KimJorgensen/KungFuFlash2/pics/launcher.jpg

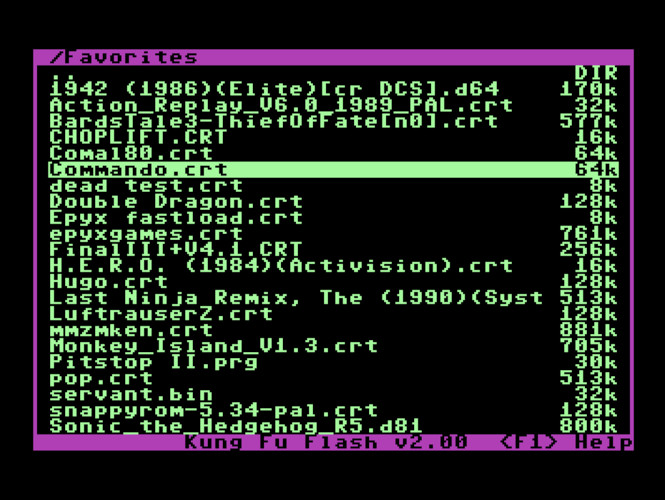
pics/launcher.jpg
