KimJorgensen/KungFuFlash2/pics/cartridge_case.jpg

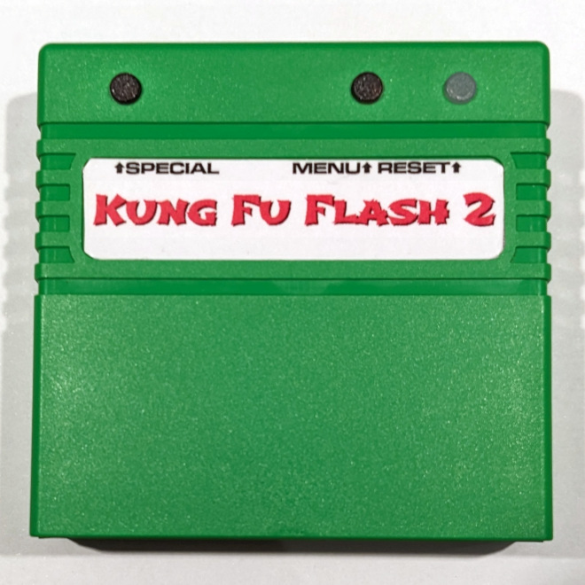
pics/cartridge_case.jpg
