KimJorgensen/KungFuFlash2/README.md

# Kung Fu Flash 2

Project is moved to https://codeberg.org/KimJorgensen/KungFuFlash2
