KimJorgensen/KungFuFlash2/pics/label_600dpi.png

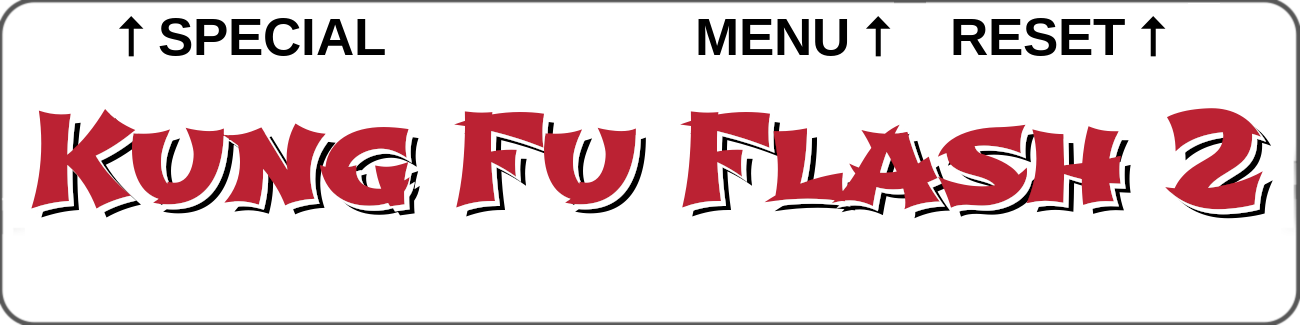
pics/label_600dpi.png
