KimJorgensen/KungFuFlash2/pics/pcb_prototype.jpg

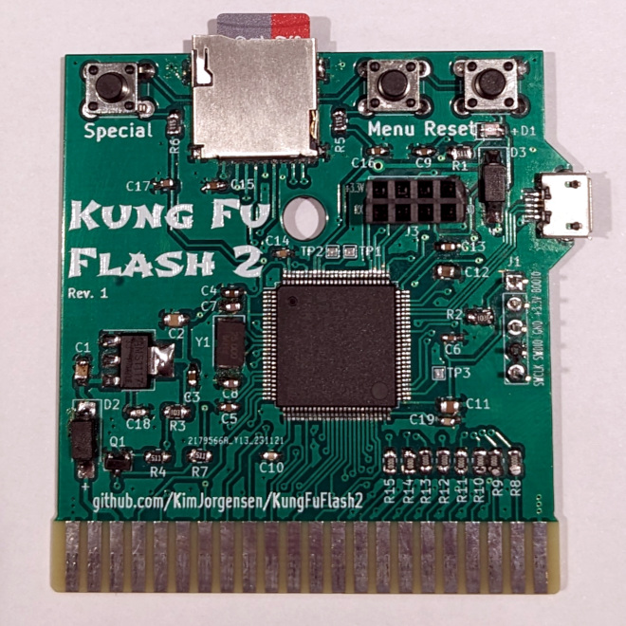
pics/pcb_prototype.jpg
