KimJorgensen/KungFuFlash2/(threads)

Thread 3 (2024-12-22):

Commodore 64C problem

LouDnl, 2024-12-22:
This issue is indirectly related to
https://github.com/KimJorgensen/KungFuFlash/issues/89

Sorry in advance for bumping an old issue for another cartridge in this repo.
I seem to have a very similar issue with my Rev A but then with Kungfu Flash 2.
Kf2 works fine in other mainboards, but in the rev A only a black screen appears.
Any tips or pointers on where too start with getting it to work?
I know the cartridge works, the diagnostics menu starts a serial log over USB and I can change the timing (max 30 up and down).

**Serial log:**
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

**Mainboard:**
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

**Clock:**
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

**Video output check of black screen:**
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

**Magicdesk reference signal:**
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

KimJorgensen, 2024-12-26:
It could be that your C64C requires a small positive [phi2 clock offset](https://github.com/KimJorgensen/KungFuFlash2/blob/main/firmware/README.md#diagnostic) or that there is a hardware connection issue. You could try to clean the connector on the PCB.

LouDnl, 2024-12-26:
> It could be that your C64C requires a small positive [phi2 clock offset](https://github.com/KimJorgensen/KungFuFlash2/blob/main/firmware/README.md#diagnostic) or that there is a hardware connection issue. You could try to clean the connector on the PCB.

I have tried this from -30 up to +30 without success unfortunately. Since 30 is the max offset I have tried adjusting the max offset in your firmware which allows me more then 30, but u fortunately the offset is still maxed at 30 somewhere else.
It's not the cartridge, as another kff2 cartridge that is tested to work in a c64 has the same issue in mine.
So that leaves the motherboard cartridgeslot or the need for a larger then 30 offset I guess?

KimJorgensen, 2024-12-26:
It is unlikely that you need a offset larger than 30. Normally an offset of one or two should fix the issue.
Maybe the expansion slot is dirty or broken. Have you tried with another cartridge like Easy Flash or Final Cartridge III?

LouDnl, 2024-12-26:
> It is unlikely that you need a offset larger than 30. Normally an offset of one or two should fix the issue.
> Maybe the expansion slot is dirty or broken. Have you tried with another cartridge like Easy Flash or Final Cartridge III?

Atm I only have 2 MagicDesk cartridges besides kff2 and they work fine.

LouDnl, 2024-12-28:
Issue found and fixed, wasn't kff2 related in the end. It turned out to be a trace on the underside of the pcb that got damaged when replacing the old RF module with a replacement one.
This trace was for Read/Write, kind of important I recon 🤣
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

KimJorgensen, 2024-12-28:
Great! I'll close this issue

Closed 2024-12-28.

Thread 4 (2024-12-26):

Bom error

ZaPpi3, 2024-12-26:
Y1 is a 4pin part in the BOM and the footprint is for 2pin part.
Something like this should work:
https://www.aliexpress.com/item/1005008177194359.html

KimJorgensen, 2024-12-28:
Thank you for reporting. The BOM has now been updated with a new link.

Closed 2024-12-28.

Thread 6 (2025-01-06):

Kung Fu Flash 2 - timing issue on MEGA65 (looks similar to KFF issue #195)

adtbm, 2025-01-06:
**Describe the bug**
Using the KFF2 in MEGA65, not possible to enter Menu again after selecting a CRT or D64.
**Probable timing issues**. The screen flickers, changes whenever i press the menu button again, but menu will not loaad

Only when i delete the KFF2.cfg on the SDcard then the menu shows up again (until ii select next file)

**To Reproduce**
Steps to reproduce the behavior:
1. power MEGA65 on
2. select a CRT or D64
3. once started, press menu button

**Expected behavior**
It should go back to KFF2 menu.

If applicable, add screenshots to help explain your problem.
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

**Kung Fu Flash 2 (please complete the following information):**
 - Hardware: Rev. 1
 - Firmware: 2.02
**Computer (please complete the following information):**
 - Device: MEGA65
 - Kernal: stock & JiffyDOS

**Additional context**
Add any other context about the problem here.

KimJorgensen, 2025-01-11:
The Kung Fu Flash 2 is only intended to be used with original Commodore hardware as stated in the README:
`Kung Fu Flash 2 will work with the PAL and NTSC version of the Commodore 64 or Commodore 128.`

I'll label this as "won't fix", unless someone is willing to analyze exactly why there is an incompatibility with the MEGA65 and can come up with a compelling reason why this requires changes to the Kung Fu Flash 2 and not the MEGA65.

Sorry, but I don't have the hardware or time to support modern recreations of the Commodore 64

Closed 2025-01-17.

Thread 7 (2025-01-07):

Programming the stm

steswart, 2025-01-07:
I have built and programmed a couple of your original kung fu flash carts without any issue. However i am unable to program tis STM chip with the same st-link v2 programmer.
Could it be fake ic’s? I used the aliexpress link from your BOM.

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

i am getting an unable to connect issue. All pins are soldered properly with no shorts.

i am missing the Schotty diodes, but surely i do not need them to program the STM32?

steswart, 2025-01-10:
I managed to program it with dfu-util command line.

steswart, 2025-01-14:
Lol, as you can see from the screenshot on top I used the wrong programming software.
It also programs fine with stmcubeprogrammer.

Closed 2025-01-10.

Thread 9 (2025-01-14):

Kernal emu

dikdom, 2025-01-14:
Hello Kim,

I just would like ask if you're planning to implement the kernal switch feature which wasn't possible with the original KFF. I was wondering if this more powerful MCU would be capable of handling the proper lines with proper timing...

Thanks!

kiFlaFlaki, 2025-01-15:
Also same question. That indeed will be fantastic feature!

dlasher, 2025-03-18:
+1 fantastic idea for a great product

Thread 13 (2025-02-03):

fimware installation problem KFF2

Kingagames77, 2025-02-03:
Hello. I've got problem to connect cart to ST-Link V2 programmer
 ST-LINK SN : 6068FF286068FF286068FF28
20:01:57 : V2J39S7
20:01:57 : Connected via SWD.
20:01:57 : SWD Frequency = 4,0 MHz.
20:01:57 : Connection mode : HotPlug.
20:01:57 : Debug in Low Power mode enabled.
20:01:57 : Can not connect to the target!
20:02:05 : Unexpected error

Unexpected error? Am I doing something wrong. With KFF1 there's no problem to connect.
Please help

Kingagames77, 2025-02-03:
Sorry I didn't use right program stm32cubeprogrammer but after installed and connected, started programming and...

20:40:32 : Opening and parsing file: KungFuFlash_v2.02.bin
  20:40:32 : Memory Programming ...
  20:40:32 :   File          : KungFuFlash_v2.02.bin
  20:40:32 :   Size          : 128.00 KB
  20:40:32 :   Address       : 0x08000000
  20:40:32 : Download in Progress:
  20:40:33 : File download complete
  20:40:33 : Time elapsed during download operation: 00:00:00.990
  20:40:33 : Verifying ...
  20:40:33 : Read progress:
  20:40:34 : Error: Data mismatch found at address  0x08000000 (byte = 0x38 instead of 0x00)
  20:40:34 : Error: Download verification failed
  20:40:34 : Memory [0x08000000 : 0x08020000] - Checksum : 0x01A4E236

steswart, 2025-02-03:
I had a problem too, but it worked every time for me when I used the USB method below.

USB
Add a jumper to short BOOT0 and +3.3V on J1. This will ensure that the board is started in DFU mode.

Use [dfu-util](http://dfu-util.sourceforge.net/) to install the firmware:

dfu-util -a 0 -s 0x08000000 -D KungFuFlash_v2.xx.upd

The jumper should be removed after the firmware has been installed.

Kingagames77, 2025-02-05:
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
What am I doing wrong??

Closed 2025-03-13.

Thread 14 (2025-02-09):

KFF2 Feature proposal at forum64.de

jueank, 2025-02-09:
Hi Kim,
I wrote you a private message in forum64.de. It's a feature proposal for KFF2, but not a straight forward one. It would be very nice if you will have a look. And sorry for raising an issue here. I could not find any other contact data.

Closed 2025-04-07.

Thread 15 (2025-02-21):

Menu button freezes C64

haktho, 2025-02-21:
I'm reaching out hoping to get some help with an issue I have using the Kung Fu Flash. The Menu button does not work. The screen is filled with garbage and the C64 freezes. The computer is a breadbin with a 250425 motherboard. I have run the Diagnostic Cartridge Rev. 586220 with harness, and everything seems ok, and that is the only other cartridge I have.

- I have tried to change the phi2 offset, both increasing and decreasing it, but with no effect.
- I have done thorough cleaning of both cartridge and port and also put support under the pcb to prevent flexing when pressing the buttons. To rule out bad contact.
- I have done visual inspection of the C64 motherboard solder joints and done _some_ continuity testing

Cartridge images seem to work fine though (the KFF works on another 250425 C64, that is how I can select a crt file to use, and also adjust the phi2 offset). Could there be some problem with the reset circuit involving the cartridge port specifically, as the Reset button on the KFF does not work either? Any help is much appreciated. (I have read the existing old issue threads, without finding a solution)

Thanks!

KimJorgensen, 2025-02-21:
The reset button should work and this does indeed suggest a problem with reset circuit.

I would recommend measuring the reset signal on expansion port and see what happens when you press the reset button

haktho, 2025-02-22:
Thank you so much for responding, here are some updates.

Reset circuit continuity verified all over the board.
•	Expansion port pin3
•	U18 SID pin5
•	U8 7406 pin8
•	U1 and U2 CIAs pin34
•	U7 CPU pin40
•	User port pin3
•	C154
•	R36

When using the reset button on the KFF the green led on the cartridge lights up and stays on.
My diagnostic cartridge also has a reset button, so I tested that, and it works fine.

I have also measured the reset signal. When using reset button on KFF the reset signal does not go low, it stays high. When using the reset on diagnostic cartridge the reset signal goes low, and then high again when the C64 is reset.

Some additional information that might be helpful in troubleshooting.
•	The CPU is mos 8500R3, not the regular 6510
•	The U20 556 is somewhat odd amongst the other chips on the board. It is a TI NE556N.

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

KimJorgensen, 2025-02-23:
I would have expected a voltage drop on the reset line when pressing the reset button. Is there continuity from the reset line on C64 to Q1 on the Kung Fu Flash 2?

It could also be a problem with R3 or R4 on the Kung Fu Flash 2. You could measure the resistance of these. There is also the possibility that Q1 is bad and needs to be replaced

haktho, 2025-02-23:
Continuity from reset line on the motherboard to Q1 verified.
Resistance measured on R3 and R4 are 9.9k and 509 Ohms.

I now see that I opened the issue for the wrong repo, I have a Kung Fu Flash (https://github.com/KimJorgensen/KungFuFlash), not version 2. Sorry about that. Should I close this one, and open another in the correct repo?

KimJorgensen, 2025-02-23:
You can just leave the issue here. The reset circuit is the same on both Kung Fu Flash 1 and 2.

Which transistor did you use for Q1?

haktho, 2025-02-25:
BC817-40, JLC-PCB part number C8589.

Also I am experiencing more and more issues with the KFF, even on the other C64 where the cartridge previously worked fine. Like random reset, game errors, crts wont work, read/write errors from both disk and tape. When I remove the KFF everything works fine.

KimJorgensen, 2025-03-15:
Sounds like a hardware problem with your Kung Fu Flash cartridge. Sorry, I can't help with that

Closed 2025-03-15.

Thread 16 (2025-02-23):

Reset will not work on MEGA64 (yet)

Kugelblitz360, 2025-02-23:
More a type of warning then an actual issue that Kim can fix:

Once a .crt is mounted, any kind of Reset, including Power Cycling, will fail on a MEGA65. My guess is that while the KFF2 initializes, it pulls the DMA line to halt the CPU (like Sidekick64). This will fail with a MEGA65 as it does not honour the DMA line (yet) in the C64 core.

Pressing the MENU button will work, so you will not be in an unusable state, but don't be alarmed when your screen stays black after you turn on your MEGA65 - you just need to press MENU.

KimJorgensen, 2025-02-23:
For info, Kung Fu Flash 2 does not use the DMA line during reset or for the menu. The DMA line is only used by the REU emulation

Kugelblitz360, 2025-02-23:
Thanks, then we need to debug the reset behaviour on our end.

Thread 21 (2025-03-18):

FEATURE REQUEST: CLEAR LAST SAVED

dlasher, 2025-03-18:
**Is your feature request related to a problem? Please describe.**
Yes. Often when booting or rebooting, I'd like the KFF2 to come up with ZERO loaded CRT/D64/etc. If you have a D64 selected for example, hitting reset will not go into the cart, but auto-mount the D64, and auto load the first program.

**Describe the solution you'd like**
Three notes:
1. top or bottom banner should show currently saved choice "CASWOLF.D64" or "supersnap5.crt"
2. In the menus - have a key/F5 for "clear last saved" or "selected = none"
3. In the settings - have an option for "auto clear last choice on cold boot"

Thank you!

erebos007, 2025-05-05:
F8 is killing everything, Menu included alas. Then after reboot the Menu does not show up automatically.
Would it be possible to make it a kill and restore menu  or make it delete the .kff2.cfg settings file ?

Thread 28 (2025-06-25):

PCBWay: question with assembly

ragraphics, 2025-06-25:
Hi,
I am interested in your Kungfu flash v 2 on PCBway,
but they say to me:
"
There are some questions in the BOM and we have not received a response after contacting the author several times, so we cannot provide a full quote, this order cannot be processed.
Or could you pls check and reply the questions in the attached file?
"

Can you help me?

ragraphics, 2025-06-25:
[Kung Fu Flash v2.00 by Kim J_rgensen_BOM_PCBWay_20241125.xlsx](https://github.com/user-attachments/files/20902400/Kung.Fu.Flash.v2.00.by.Kim.J_rgensen_BOM_PCBWay_20241125.xlsx)

ragraphics, 2025-06-25:
is this kungfu flash a REU expansion memory for C64?

KimJorgensen, 2025-06-25:
Sorry, but I'm not the author of the project on PCBWay. Please restrict issues to the content of this repository.

The REU feature is described in the readme

Closed 2025-06-25.

Thread 29 (2025-07-20):

Incorrect 30719 BASIC BYTES shown when KFF2 used with JaffyDOS

oschonrock, 2025-07-20:
- KFF2 with firmware 2.0.3
- C64C shortboard
- JaffyDOS v1.3 - stock ROM and JiffyDOS are fine

To reproduce:
1. install JaffDOS
2. plug in KFF2
3. from KFF2 menu select "F8 Kill"  ( "F7 - Basic" always exhibits problem as well)

c64 boot screen will show "JaffyDOS - 30719 bytes free"...
Press KFF2 reset button multiple times.
The full and correct 38911 bytes free will be shown ~30% of the time. The other 70% it is 30719bytes.

This "feels" like a race condition.

Some investigation suggests this 300ms delay might could be related:

```c
        case DAT_KILL:
        {
            c64_disable();
            C64_CRT_CONTROL(STATUS_LED_OFF|CRT_PORT_8K); // <-- CRT ROM seems to be active here
            c64_reset(false); // release RESET
            delay_ms(300);
            C64_CRT_CONTROL(CRT_PORT_NONE); // <-- CRT ROM removed
            result = true;
        }
        break;
```

KimJorgensen, 2025-07-20:
The reason is to make the reset unstoppable - see https://www.c64-wiki.com/wiki/Reset_Button

oschonrock, 2025-07-20:
> The reason is to make the reset unstoppable - see https://www.c64-wiki.com/wiki/Reset_Button

That's nice... and does that mean it's normal /intended to lose 8kB RAM if the Kernal is faster than expected? (If indeed that is the reason this is happening.)

KimJorgensen, 2025-07-20:
No it was not intended to lose 8kB RAM. I wonder if it is possible to select a delay that would work with all kernals

oschonrock, 2025-07-20:
> No it was not intended to lose 8kB RAM. I wonder if it is possible to select a delay that would work with all kernals

Maybe difficult... but, if you think it is as simple as adjusting that delay - you have the overview - it might it be possible to make the delay a configuration option, so people can customise it to work with JaffyDOS or whatever?

Plus publish some numbers that work with common options.

KimJorgensen, 2025-07-20:
You can use F6 as a workaround. The reset will however not be unstoppable

RetroNynjah, 2025-07-20:
I don't have a working build environment but if someone can build a few test versions with different delays, we can test what works with JaffyDOS and what doesn't.
It won't tell us what works best for everyone but at least we will know what would be needed for JaffyDOS to work correctly.

RetroNynjah, 2025-07-21:
There are several other Kernals that skip the RAM test and just check the block starting at $8000.
SpeedDOS and DolphinDOS are two examples and they both show the same behaviour as JaffyDOS. I haven't measured if the repeatability is the same since it feels a bit random but I doubt there's a difference.

Thread 32 (2025-08-05):

Can not connect to the target

ragraphics, 2025-08-05:
ST-Link v2 message error "Can not connect to the target".

I am using windows 10 Pro and a new installation of STM32 ST-LINK Utility v.4.6

In the picture you can see the connection between KFF2 and ST-Link v2 :
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

This is the configuration of ST-Link v2:
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

When I try to connect, here is the message error:
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

This is my board of KFF2 and I am trying to flash the first firmware:
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

Please help me!!!

Thread 33 (2025-08-07):

What is the J3 connector for, how can I use it?

ragraphics, 2025-08-07:
What is the J3 connector for, how can I use it?

KimJorgensen, 2025-08-09:
It is intended for wifi support but there is no support for that in the current firmware.
I'll close this as a duplicate

Closed 2025-08-09.

Thread 36 (2025-10-04):

Unstable behaviour

peppotto-sketch, 2025-10-04:
Hello,

I'm facing stabiity problem, sometimes the cartridge works as aspected sometimes it keeps resetting. I've cleaned all KF2 motherboard using isopropyl alcohol, and so i did with my old breadbin c64 cartridges connector, but nothing to do. Any time it seems to be working and stable at next run the cartridge keep back resetting. I've tried out the KF1 as well and it run great without any issue.

Any help/suggestion is really appreciated.
