KimJorgensen/KungFuFlash2/hardware/KungFuFlash2.pdf

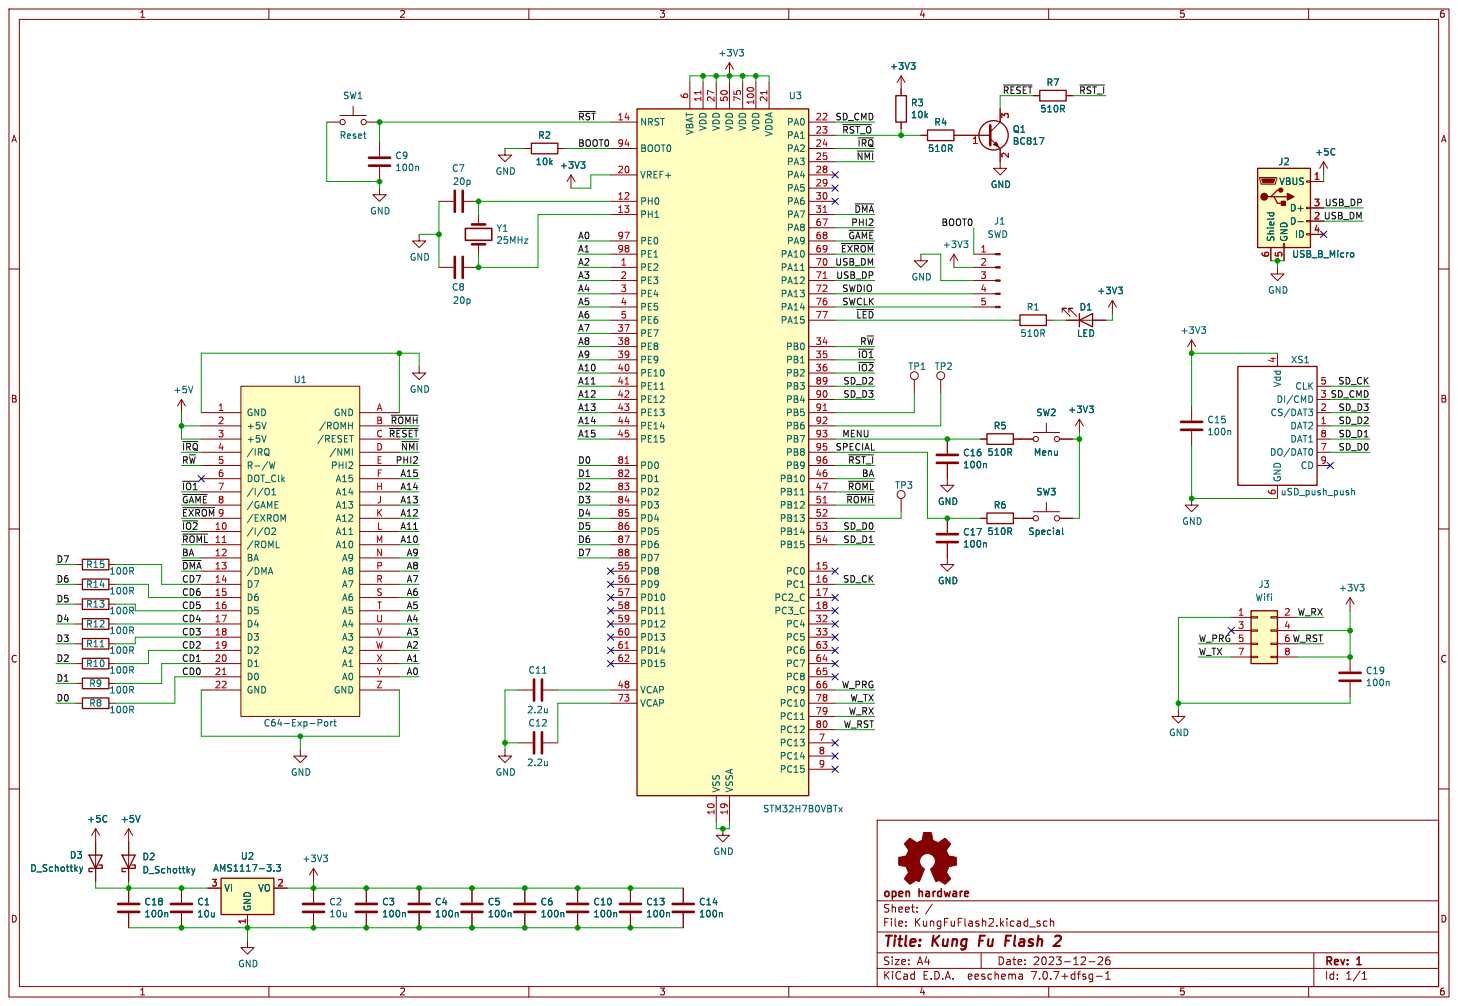
[picture p5: page 1]

Id: 1/1 Title: Kung Fu Flash 2
