KimJorgensen/KungFuFlash2/hardware/KungFuFlash2.kicad_pcb

## KiCad design hardware/KungFuFlash2.kicad_pcb (2024-06-06)

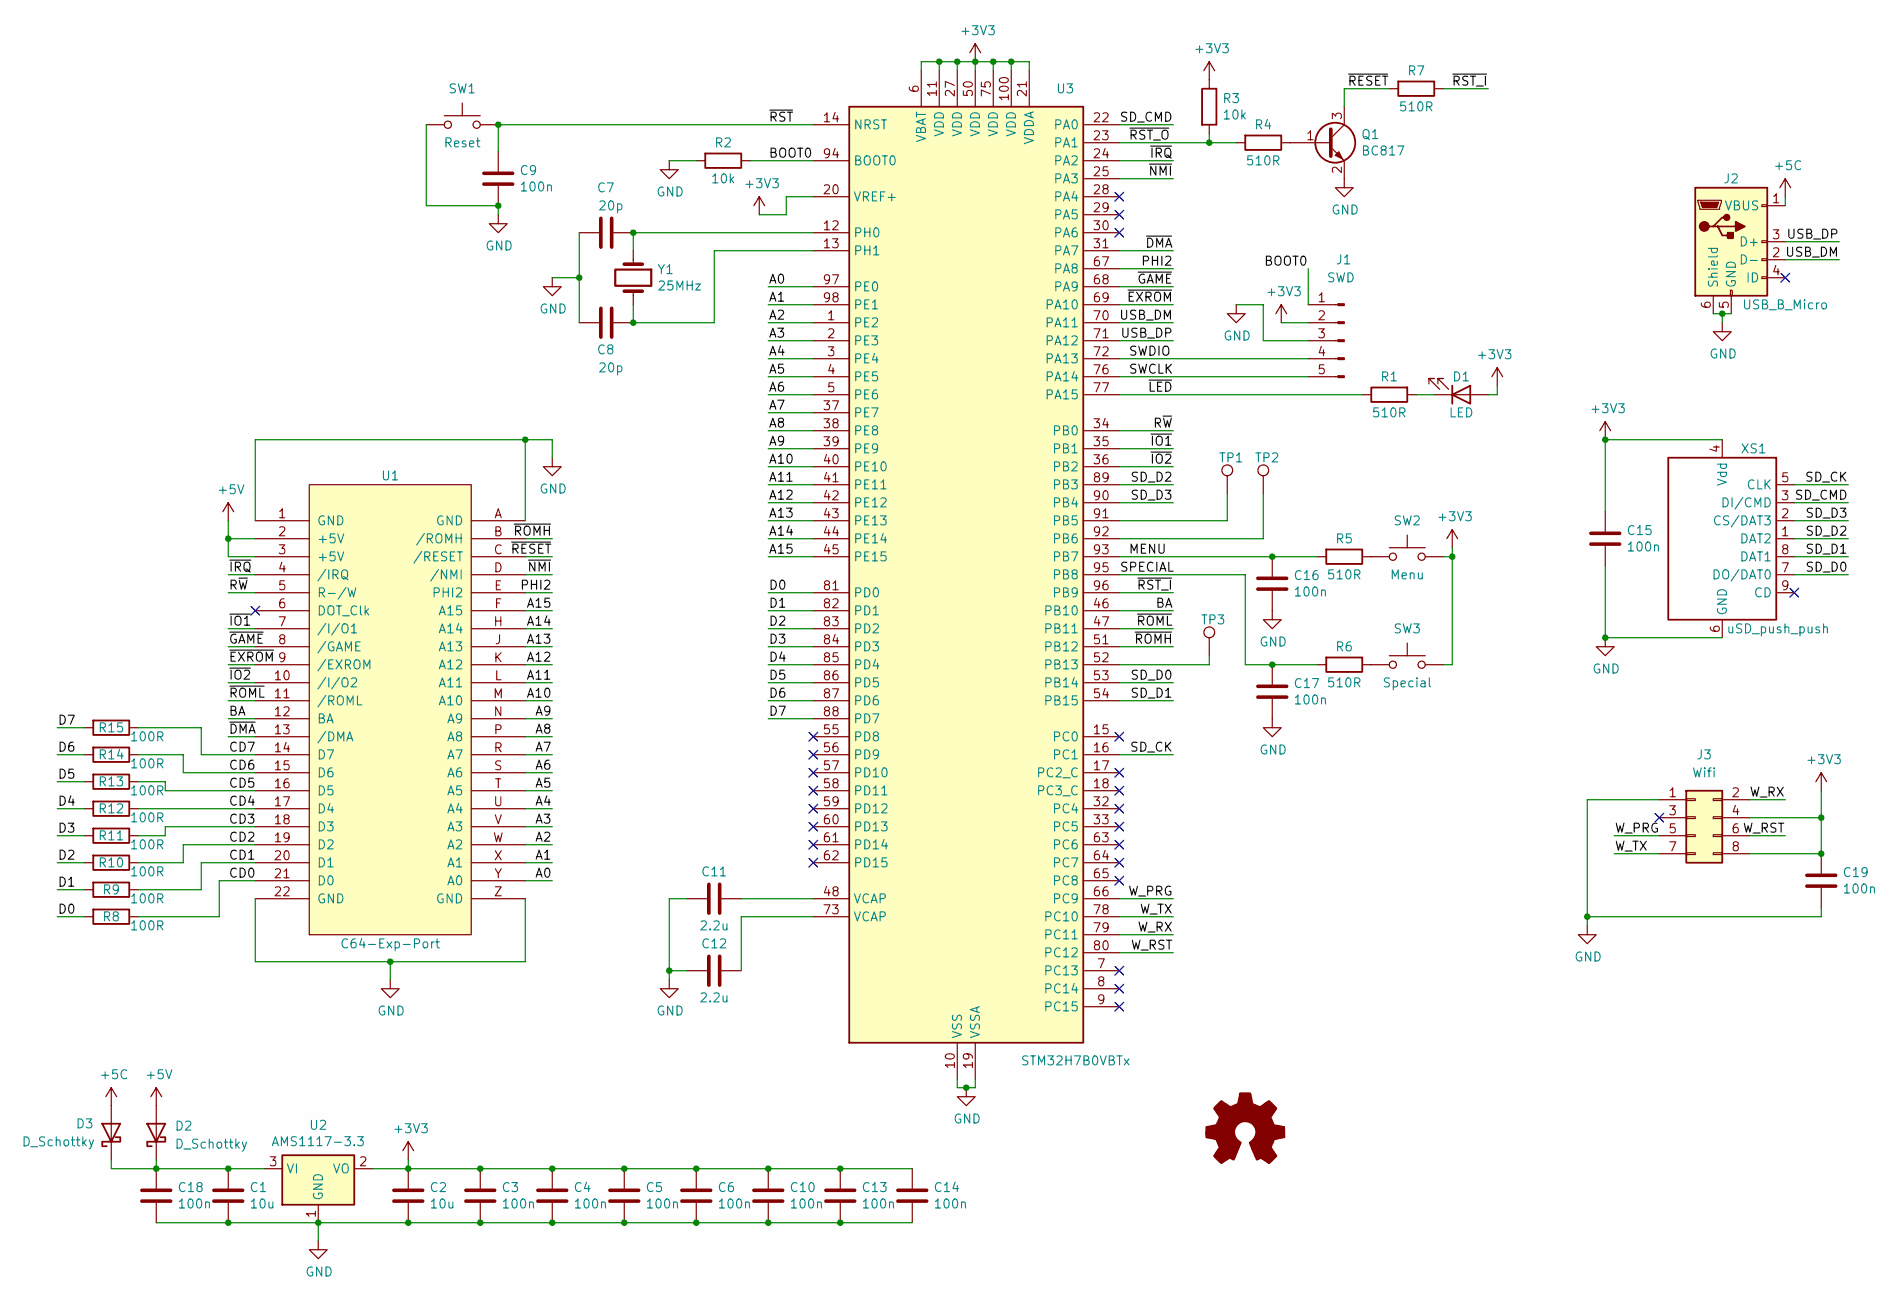
[picture p6: schematic KungFuFlash2.kicad_sch, Kung Fu Flash 2]

Parts:
C1, C2: 10u; C_0805_2012Metric_Pad1.18x1.45mm_HandSolder
C3, C4, C5, C6, C9, C10, C13, C14, C15, C16, C17, C18, C19: 100n; C_0603_1608Metric_Pad1.08x0.95mm_HandSolder
C7, C8: 20p; C_0603_1608Metric_Pad1.08x0.95mm_HandSolder
C11, C12: 2.2u; C_0805_2012Metric_Pad1.18x1.45mm_HandSolder
D1: LED; LED_0805_2012Metric_Pad1.15x1.40mm_HandSolder
D2, D3: D_Schottky; D_SMA_Handsoldering
J1: SWD; PinHeader_1x05_P2.54mm_Vertical
J2: USB_B_Micro; Conn_USBmicro-B_ebay-side_TH
J3: Wifi; PinSocket_2x04_P2.54mm_Vertical
Q1: BC817; SOT-23
R1, R4, R5, R6, R7: 510R; R_0805_2012Metric_Pad1.20x1.40mm_HandSolder
R2, R3: 10k; R_0805_2012Metric_Pad1.20x1.40mm_HandSolder
R8, R9, R10, R11, R12, R13, R14, R15: 100R; R_0805_2012Metric_Pad1.20x1.40mm_HandSolder
SW1: Reset; SW_PUSH_6mm_H8mm
SW2: Menu; SW_PUSH_6mm_H8mm
SW3: Special; SW_PUSH_6mm_H8mm
TP1, TP2, TP3: TestPoint_Pad_1.0x1.0mm
U1: C64-Exp-Port; C64-Cart
U2: AMS1117-3.3; SOT-223-3_TabPin2
U3: STM32H7B0VBTx; LQFP-100_14x14mm_P0.5mm
XS1: uSD_push_push; Conn_uSDcard
Y1: 25MHz; Crystal_SMD_5032-2Pin_5.0x3.2mm

Connections:
+3V3: C2.1, C3.1, C4.1, C5.1, C6.1, C10.1, C13.1, C14.1, C15.1, C19.1, D1.2 (A), J1.2, J3.4, J3.8, R3.1, SW2.1, SW3.1, U2.2 (VO), U3.6 (VBAT), U3.11 (VDD), U3.20 (VREF+), U3.21 (VDDA), U3.27 (VDD), U3.50 (VDD), U3.75 (VDD), U3.100 (VDD), XS1.4 (Vdd)
+5C: D3.2 (A), J2.1 (VBUS)
+5V: D2.2 (A), U1.2 (+5V), U1.3 (+5V)
/A0: U1.Y (A0), U3.97 (PE0)
/A1: U1.X (A1), U3.98 (PE1)
/A2: U1.W (A2), U3.1 (PE2)
/A3: U1.V (A3), U3.2 (PE3)
/A4: U1.U (A4), U3.3 (PE4)
/A5: U1.T (A5), U3.4 (PE5)
/A6: U1.S (A6), U3.5 (PE6)
/A7: U1.R (A7), U3.37 (PE7)
/A8: U1.P (A8), U3.38 (PE8)
/A9: U1.N (A9), U3.39 (PE9)
/A10: U1.M (A10), U3.40 (PE10)
/A11: U1.L (A11), U3.41 (PE11)
/A12: U1.K (A12), U3.42 (PE12)
/A13: U1.J (A13), U3.43 (PE13)
/A14: U1.H (A14), U3.44 (PE14)
/A15: U1.F (A15), U3.45 (PE15)
/BA: U1.12 (BA), U3.46 (PB10)
/BOOT0: J1.1, R2.1, U3.94 (BOOT0)
/CD0: R8.1, U1.21 (D0)
/CD1: R9.1, U1.20 (D1)
/CD2: R10.1, U1.19 (D2)
/CD3: R11.1, U1.18 (D3)
/CD4: R12.1, U1.17 (D4)
/CD5: R13.1, U1.16 (D5)
/CD6: R14.1, U1.15 (D6)
/CD7: R15.1, U1.14 (D7)
/D0: R8.2, U3.81 (PD0)
/D1: R9.2, U3.82 (PD1)
/D2: R10.2, U3.83 (PD2)
/D3: R11.2, U3.84 (PD3)
/D4: R12.2, U3.85 (PD4)
/D5: R13.2, U3.86 (PD5)
/D6: R14.2, U3.87 (PD6)
/D7: R15.2, U3.88 (PD7)
/MENU: C16.1, R5.2, U3.93 (PB7)
/PHI2: U1.E (PHI2), U3.67 (PA8)
/R~W: U1.5 (R-/W), U3.34 (PB0)
/SD_CK: U3.16 (PC1), XS1.5 (CLK)
/SD_CMD: U3.22 (PA0), XS1.3 (DI/CMD)
/SD_D0: U3.53 (PB14), XS1.7 (DO/DAT0)
/SD_D1: U3.54 (PB15), XS1.8 (DAT1)
/SD_D2: U3.89 (PB3), XS1.1 (DAT2)
/SD_D3: U3.90 (PB4), XS1.2 (CS/DAT3)
/SPECIAL: C17.1, R6.2, U3.95 (PB8)
/SWCLK: J1.5, U3.76 (PA14)
/SWDIO: J1.4, U3.72 (PA13)
/USB_DM: J2.2 (D-), U3.70 (PA11)
/USB_DP: J2.3 (D+), U3.71 (PA12)
/W_PRG: J3.5, U3.66 (PC9)
/W_RST: J3.6, U3.80 (PC12)
/W_RX: J3.2, U3.79 (PC11)
/W_TX: J3.7, U3.78 (PC10)
/~DMA: U1.13 (/DMA), U3.31 (PA7)
/~EXROM: U1.9 (/EXROM), U3.69 (PA10)
/~GAME: U1.8 (/GAME), U3.68 (PA9)
/~IO1: U1.7 (/I/O1), U3.35 (PB1)
/~IO2: U1.10 (/I/O2), U3.36 (PB2)
/~IRQ: U1.4 (/IRQ), U3.24 (PA2)
/~LED: R1.1, U3.77 (PA15)
/~NMI: U1.D (/NMI), U3.25 (PA3)
/~RESET: Q1.3 (C), R7.2, U1.C (/RESET)
/~ROMH: U1.B (/ROMH), U3.51 (PB12)
/~ROML: U1.11 (/ROML), U3.47 (PB11)
/~RST_I: R7.1, U3.96 (PB9)
/~RST_O: R3.2, R4.2, U3.23 (PA1)
/~RST: C9.1, SW1.2, U3.14 (NRST)
GND: C1.2, C2.2, C3.2, C4.2, C5.2, C6.2, C7.1, C8.1, C9.2, C10.2, C11.1, C12.2, C13.2, C14.2, C15.2, C16.2, C17.2, C18.2, C19.2, J1.3, J2.5 (GND), J2.6 (Shield), J3.1, Q1.2 (E), R2.2, SW1.1, U1.1 (GND), U1.22 (GND), U1.A (GND), U1.Z (GND), U2.1 (GND), U3.10 (VSS), U3.19 (VSSA), U3.26 (VSS), U3.49 (VSS), U3.74 (VSS), U3.99 (VSS), XS1.6 (GND)
unnamed: C11.2, U3.48 (VCAP)
unnamed: C12.1, U3.73 (VCAP)
unnamed: D1.1 (K), R1.2
unnamed: C1.1, C18.1, D2.1 (K), D3.1 (K), U2.3 (VI)
unnamed: Q1.1 (B), R4.1
unnamed: R5.1, SW2.2
unnamed: R6.1, SW3.2
unnamed: TP1.1, U3.91 (PB5)
unnamed: TP2.1, U3.92 (PB6)
unnamed: TP3.1, U3.52 (PB13)
unnamed: C7.2, U3.12 (PH0), Y1.1
unnamed: C8.2, U3.13 (PH1), Y1.2

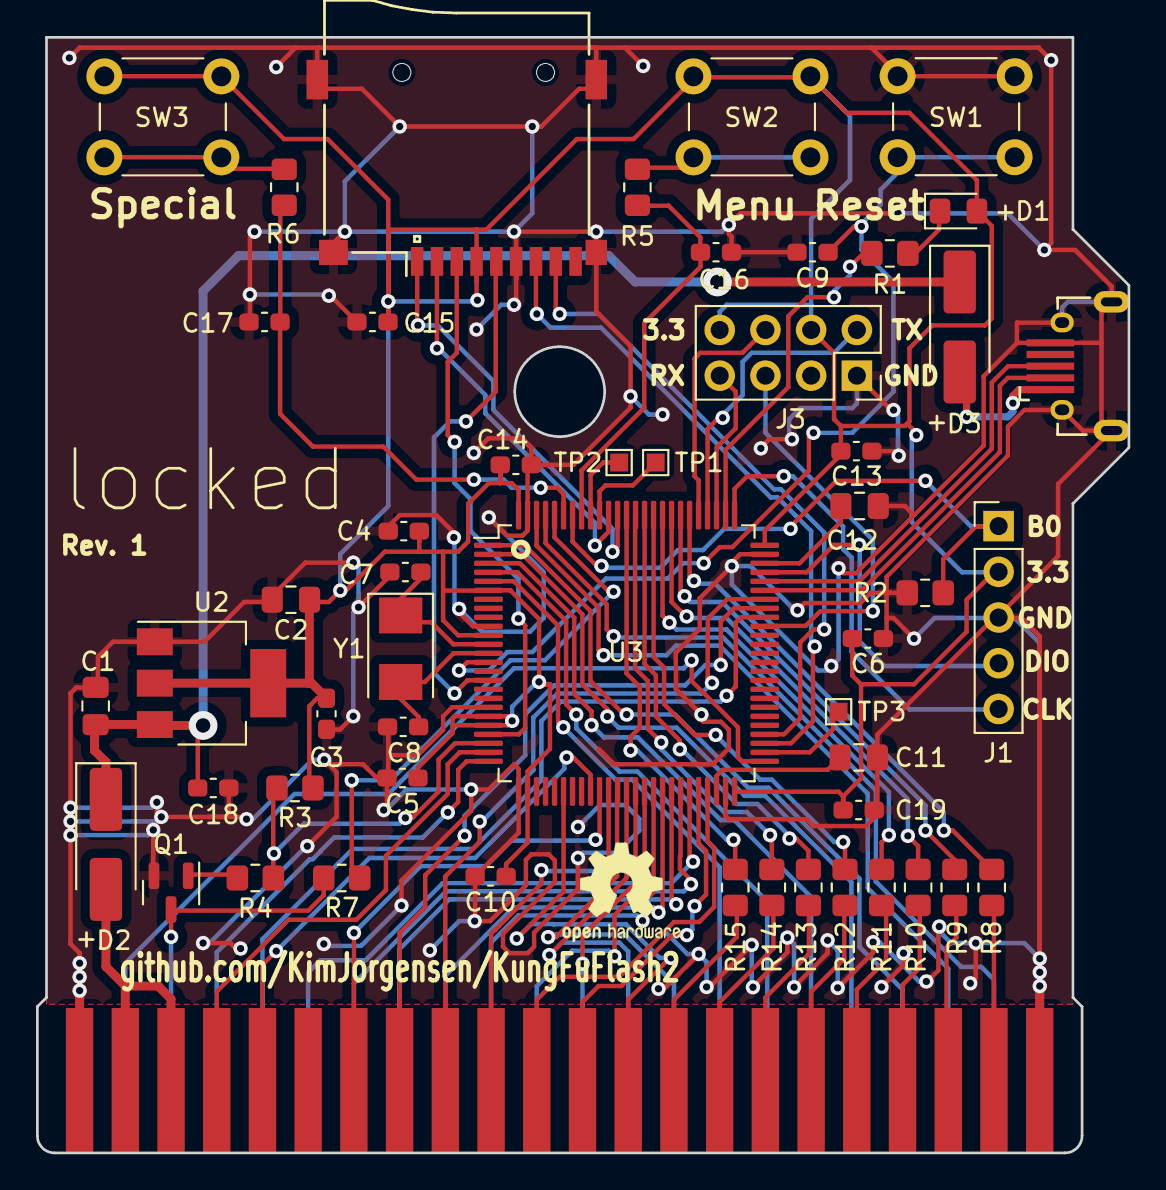
[picture p7: board KungFuFlash2.kicad_pcb from above]

Board: 2 copper layers, 60.6 x 62.0 mm, 52 parts (0 on the bottom side), 82 nets.
