KimJorgensen/KungFuFlash2/(commit log)

2025-01-04 Fix race condition in menu startup from KFF v1.52
    [main.c]
2025-11-30 Fix autoload of PRG
    [loader.c]
